CoronavirusMakers-Prototypes/Safety-Googles/Gafas EPI modelo Gerard 5.1/Medidas acetato modelo Gerard.pdf

5,5
cm

1,5
cm

19,5cm

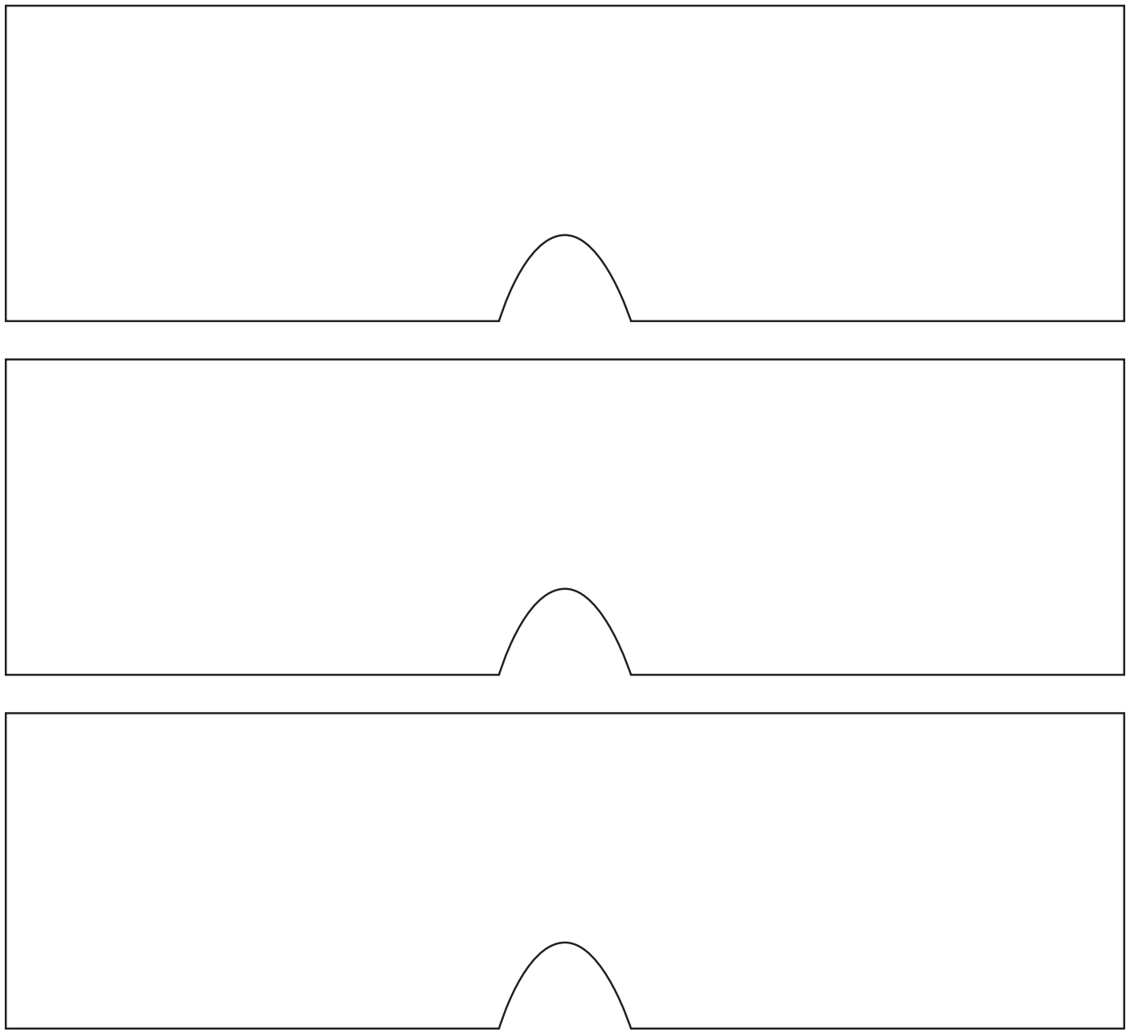
[picture p11: figure]
