CoronavirusMakers-Prototypes/Safety-Googles/88A/plantilla de corte cristal.dxf

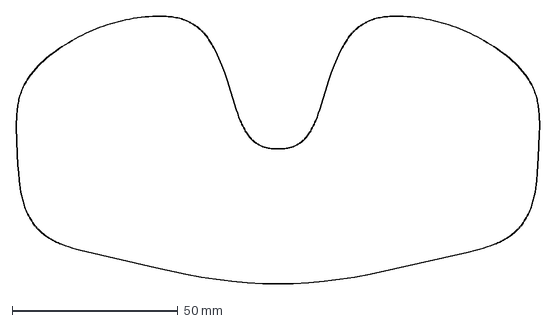
[picture p12: CAD file, 2020-04-03]
88A/plantilla de corte cristal.dxf
158.0 x 80.9 mm
