CoronavirusMakers-Prototypes/Safety-Googles/Gafas EPI modelo Gerard 5.1/STL Modelo Gerard acetato 018mm/Gafas EPI 5.1 modelo Gerard inferior (acetato 018mm).STL

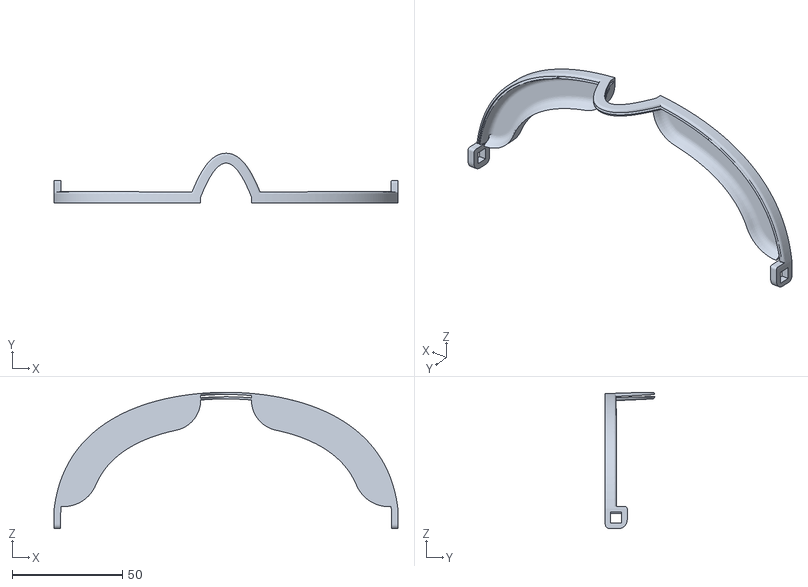
[picture p13: CAD file, 2020-04-03]
Gafas EPI modelo Gerard 5.1/STL Modelo Gerard acetato 018mm/Gafas EPI 5.1 modelo Gerard inferior (acetato 018mm).STL
156.1 x 22.5 x 61.9
