CoronavirusMakers-Prototypes/Safety-Googles/Gafas EPI modelo Gerard 5.1/STL Modelo Gerard acetato 050mm/Gafas EPI 5.1 modelo Gerard viga lateral (imprimir x2).stl

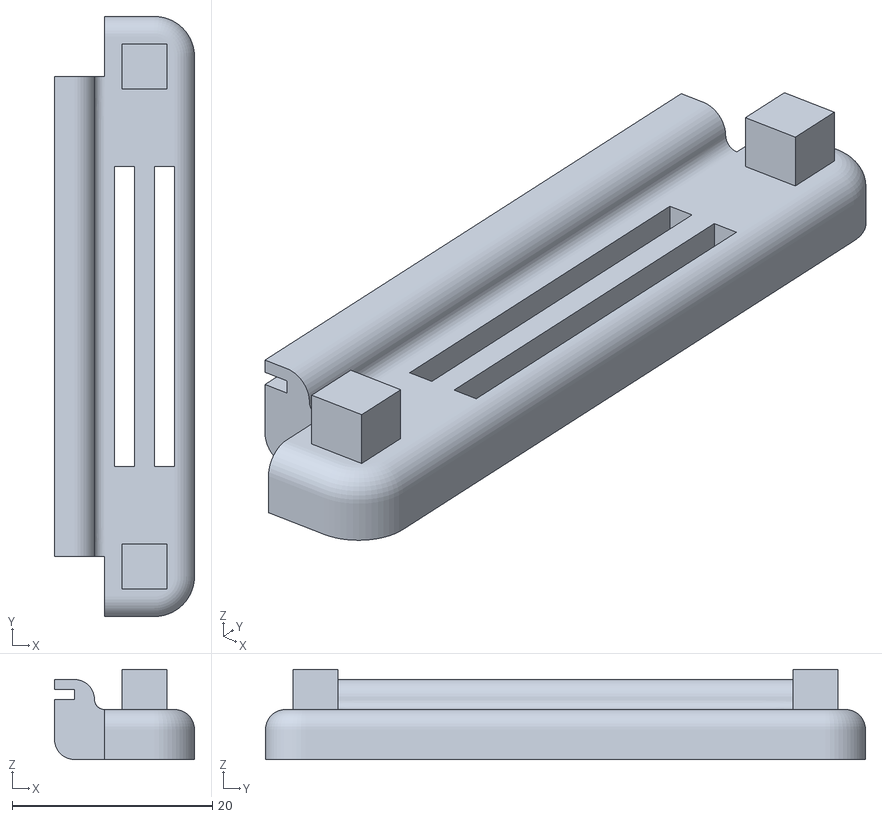
[picture p14: CAD file, 2020-04-03]
Gafas EPI modelo Gerard 5.1/STL Modelo Gerard acetato 050mm/Gafas EPI 5.1 modelo Gerard viga lateral (imprimir x2).stl
14.0 x 60.0 x 9.00
