CoronavirusMakers-Prototypes/Safety-Googles/Gafas EPI modelo Gerard 5.1/STL Modelo Gerard acetato 1mm/Gafas EPI 5.1 modelo Gerard superior (acetato 1mm).stl

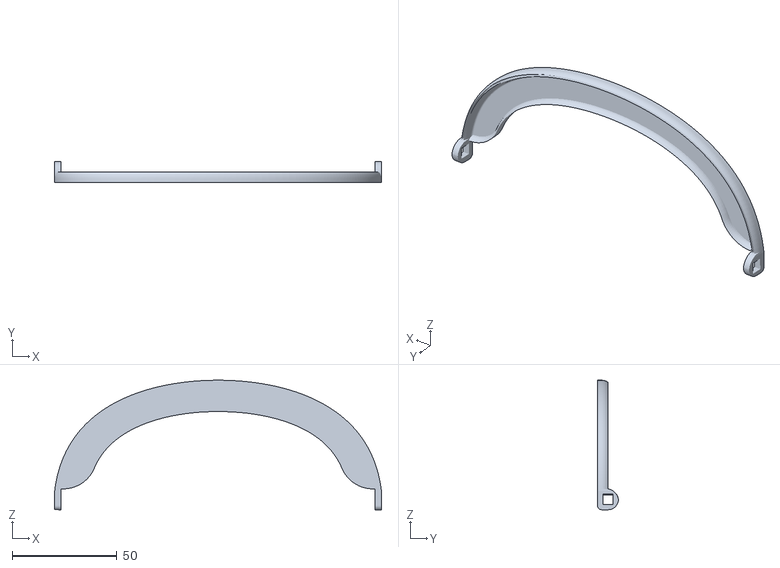
[picture p15: CAD file, 2020-04-03]
Gafas EPI modelo Gerard 5.1/STL Modelo Gerard acetato 1mm/Gafas EPI 5.1 modelo Gerard superior (acetato 1mm).stl
156.1 x 10.0 x 61.9
