CoronavirusMakers-Prototypes/Safety-Googles/Gafas EPI Modelo MakeSafe MS-20 v6.3/Modelos para impresión Gafas EPI Modelo MakeSafe MS-20 v6.3/1. Gafas EPI Modelo MakeSafe MS-20 V.6.3 Montura superior.stl

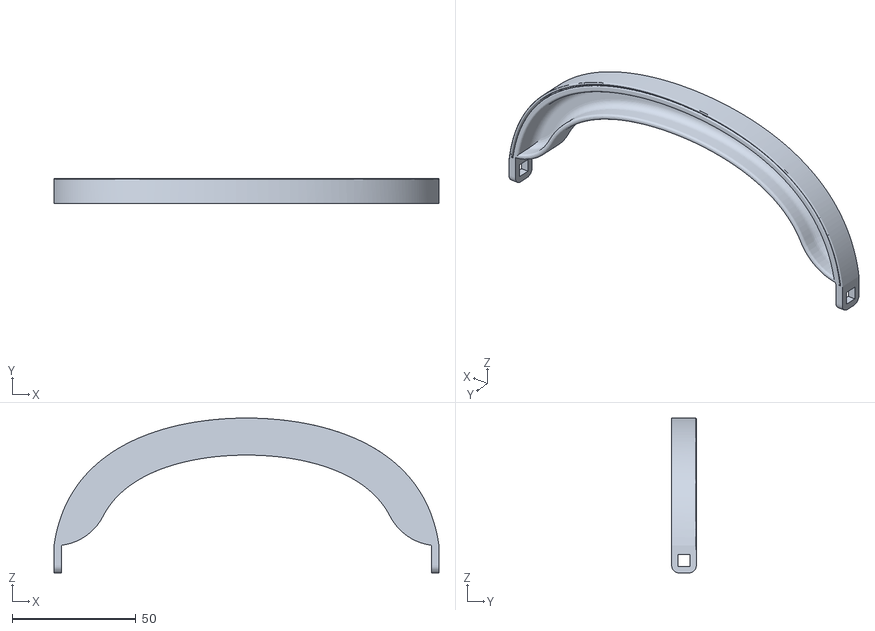
[picture p16: CAD file, 2020-04-11]
Gafas EPI Modelo MakeSafe MS-20 v6.3/Modelos para impresión Gafas EPI Modelo MakeSafe MS-20 v6.3/1. Gafas EPI Modelo MakeSafe MS-20 V.6.3 Montura superior.stl
155.7 x 10.0 x 62.6
