CoronavirusMakers-Prototypes/Safety-Googles/88A/V1.0_A88.stl

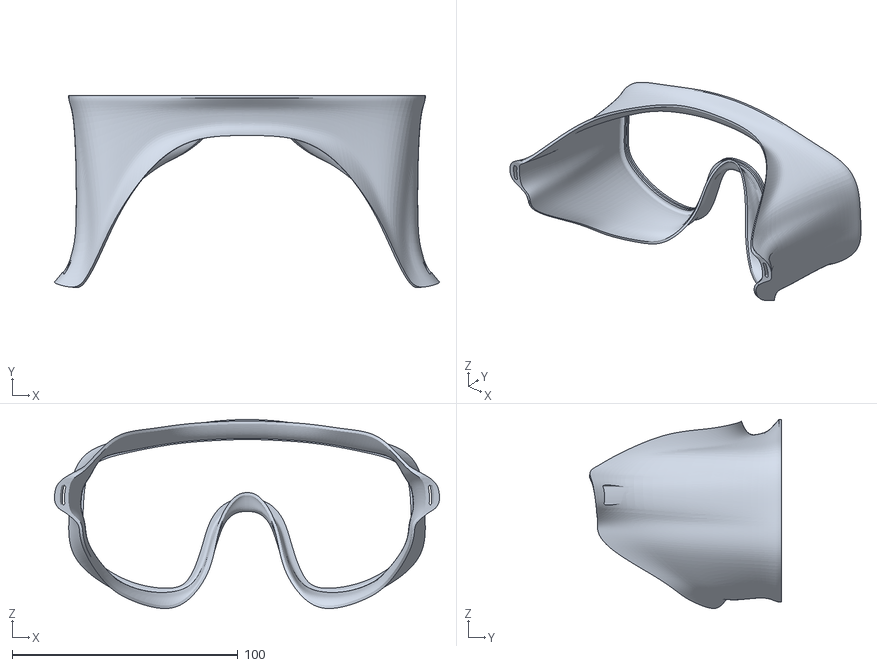
[picture p17: CAD file, 2020-04-03]
88A/V1.0_A88.stl
170.6 x 85.3 x 83.8
