CoronavirusMakers-Prototypes/Safety-Googles/Gafas EPI modelo Gerard 5.1/STL Modelo Gerard acetato 018mm/Gafas EPI 5.1 modelo Gerard superior (acetato 018mm).STL

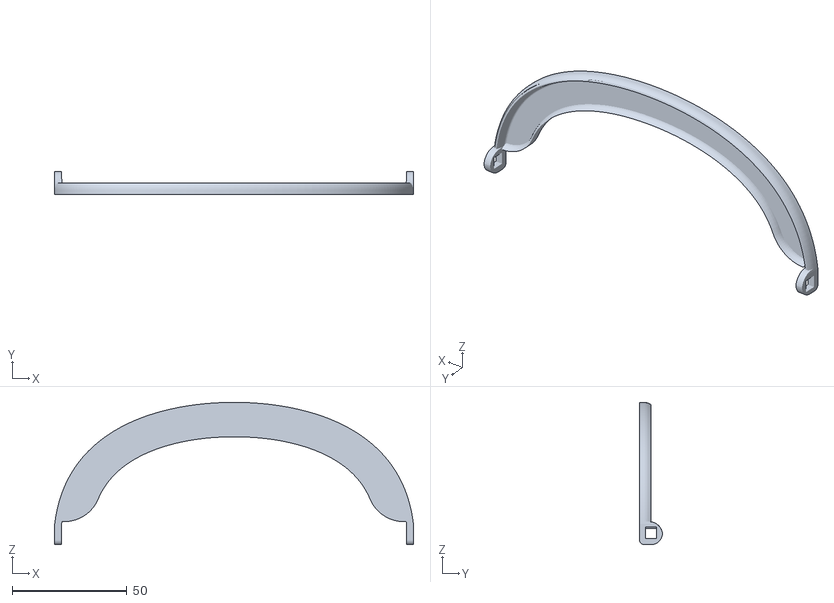
[picture p18: CAD file, 2020-04-03]
Gafas EPI modelo Gerard 5.1/STL Modelo Gerard acetato 018mm/Gafas EPI 5.1 modelo Gerard superior (acetato 018mm).STL
156.1 x 10.0 x 61.9
