CoronavirusMakers-Prototypes/Safety-Googles/Gafas EPI Modelo MakeSafe MS-20 v6.3/Modelos para impresión Gafas EPI Modelo MakeSafe MS-20 v6.3/3. Gafas EPI Modelo MakeSafe MS-20 V.6.3 Montura inferior.stl

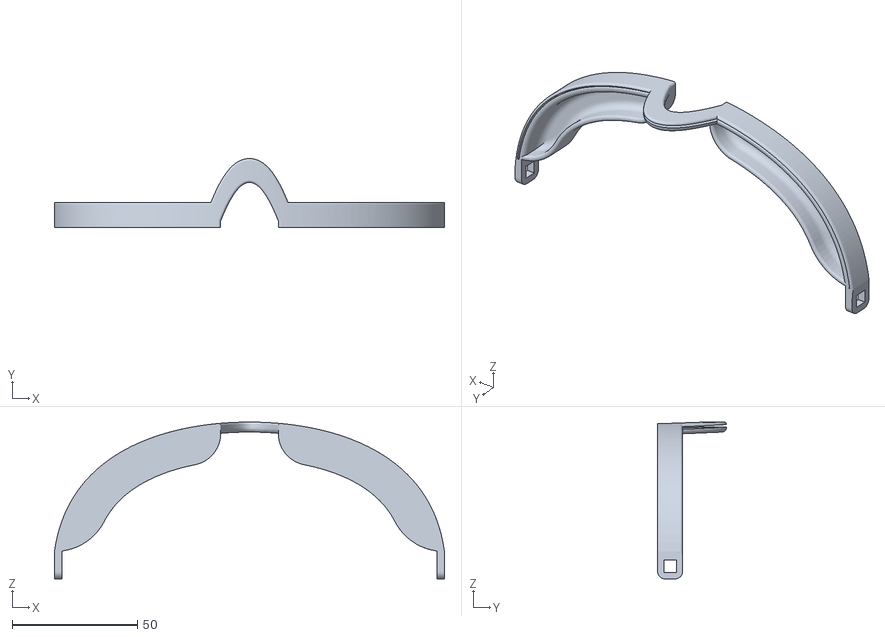
[picture p19: CAD file, 2020-04-11]
Gafas EPI Modelo MakeSafe MS-20 v6.3/Modelos para impresión Gafas EPI Modelo MakeSafe MS-20 v6.3/3. Gafas EPI Modelo MakeSafe MS-20 V.6.3 Montura inferior.stl
155.7 x 27.5 x 62.6
