CoronavirusMakers-Prototypes/Safety-Googles/Gafas EPI Modelo MakeSafe MS-20 v6.3/Modelos para impresión Gafas EPI Modelo MakeSafe MS-20 v6.3/2. Gafas EPI Modelo MakeSafe MS-20 V.6.3 Viga lateral (imprimir x2).stl

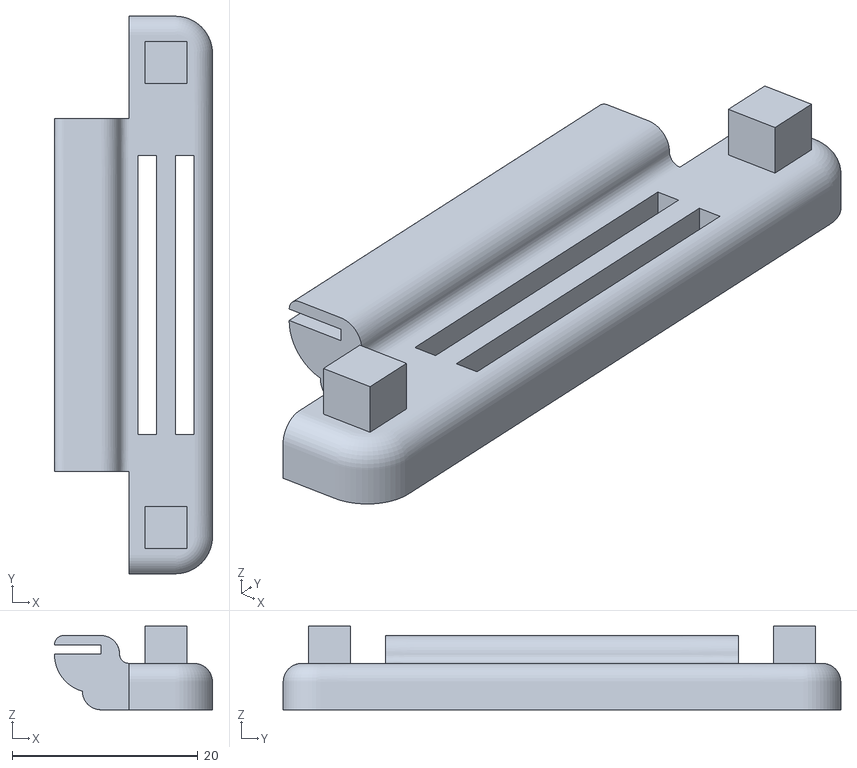
[picture p20: CAD file, 2020-04-11]
Gafas EPI Modelo MakeSafe MS-20 v6.3/Modelos para impresión Gafas EPI Modelo MakeSafe MS-20 v6.3/2. Gafas EPI Modelo MakeSafe MS-20 V.6.3 Viga lateral (imprimir x2).stl
17.0 x 60.0 x 9.00
