CoronavirusMakers-Prototypes/Safety-Googles/(list of files, cad)

Other CAD files:
Gafas EPI modelo Gerard 5.1/STL Modelo Gerard acetato 050mm/Gafas EPI 5.1 modelo Gerard superior (acetato 05mm).STL
Gafas EPI modelo Gerard 5.1/STL Modelo Gerard acetato 1mm/Gafas EPI 5.1 modelo Gerard inferior (acetato 1mm).stl
Gafas EPI modelo Gerard 5.1/STL Modelo Gerard acetato 050mm/Gafas EPI 5.1 modelo Gerard inferior (acetato 05mm).STL
