CoronavirusMakers-Prototypes/Safety-Googles/Gafas EPI Modelo MakeSafe MS-20 v6.3/Documentos de corte lámina protectora PET Gafas EPI Modelo MakeSafe MS-20 v6.3/Gafas EPI Modelo MakeSafe MS-20 V.6.3 Medidas lámina protectora PET.pdf

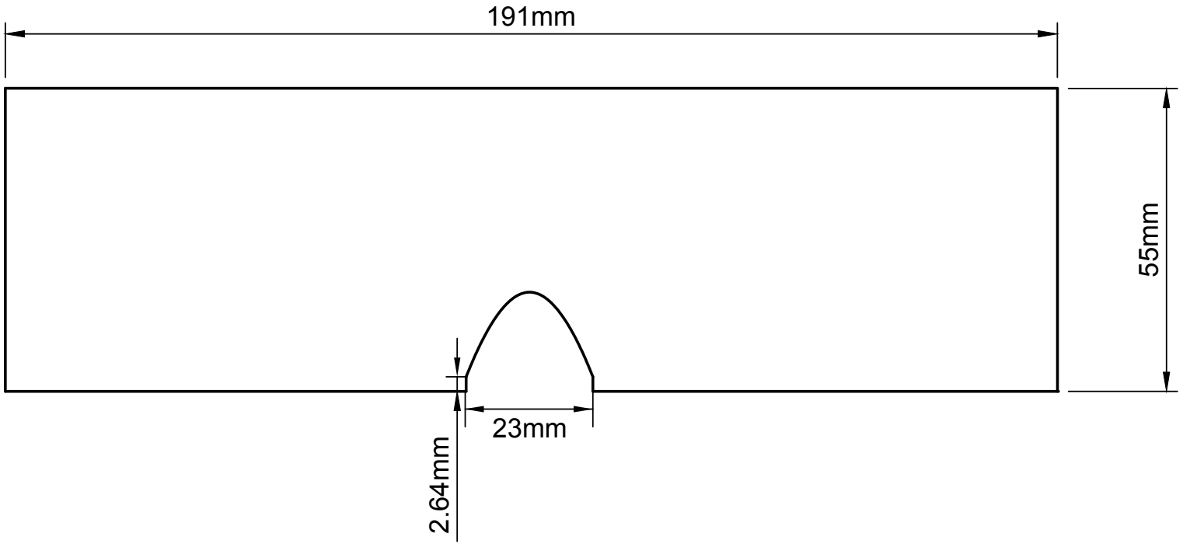
[picture p51: figure]
